Arkadip2007/F450-Drone-ESP32-FlightController/(commit log)

2026-10-17 docs: add comprehensive README, wiring guides, and sensor test suite
2026-10-17 feat(espfc): add platformio config, main entry point, and patched GyroMPU6050 driver
    [partitions_4M_nota.csv]
2026-10-18 docs: add visual schematics, configurator tour, and engineering QA journey
2026-10-18 docs(images): add ESP32 Wi-Fi AP pairing and Betaflight Configurator screenshots
2026-10-18 docs(images): add ESP32 CLI hardware pin verification screenshot
2026-10-18 docs(images): add ESP32 browser-based firmware flasher screenshot
2026-10-18 docs(images): add ESP32 I2C sensor bus complete wiring schematic
2026-10-19 docs: add Phase 1 motor control milestone and physical hardware visual tour
2026-10-19 docs(images): add handmade green perfboard top headers and perimeter ground bus photos
2026-10-19 docs(images): add complete bench motor control photo
2026-10-19 docs(images): add Betaflight minimal sensors telemetry verification photo
2026-10-19 docs(images): add author circuit inspection and workstation bring-up photos
2026-10-19 docs(images): add author bench assembly and hand-soldering photo
